Kedarius/ISPBreakout/images/pcb.jpg

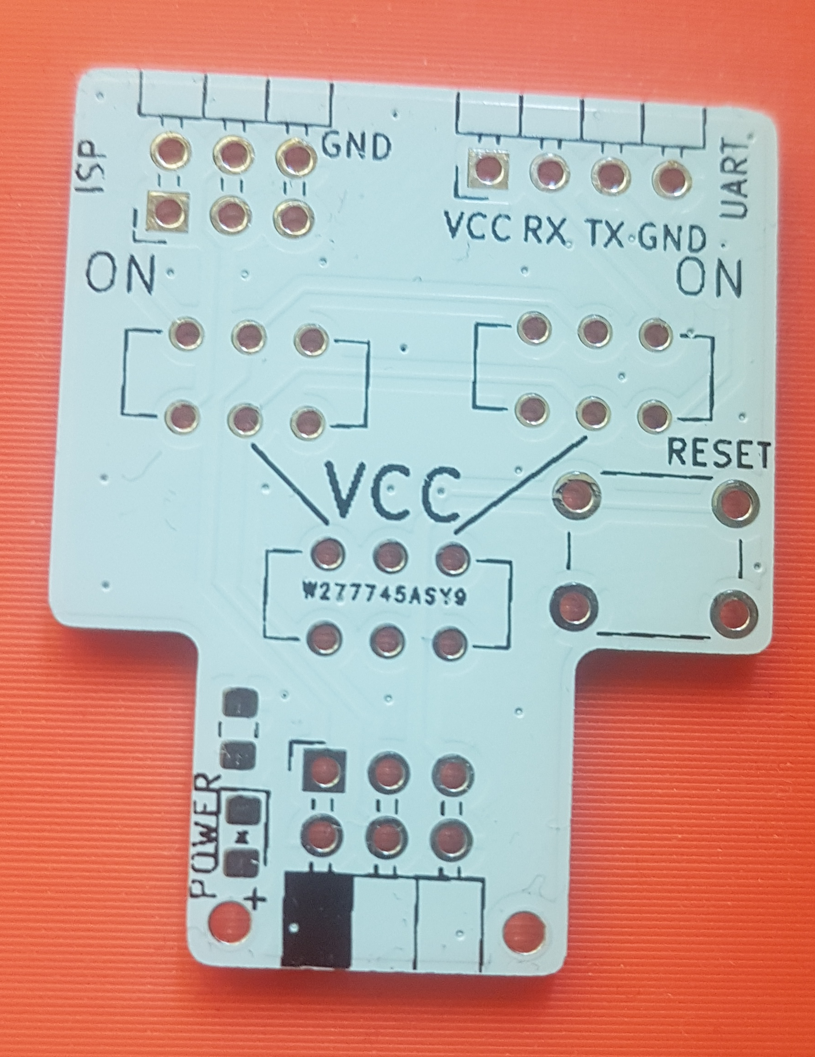
images/pcb.jpg
