Kedarius/ISPBreakout/K3-2235D/3d/K3-2235D-F1.stp

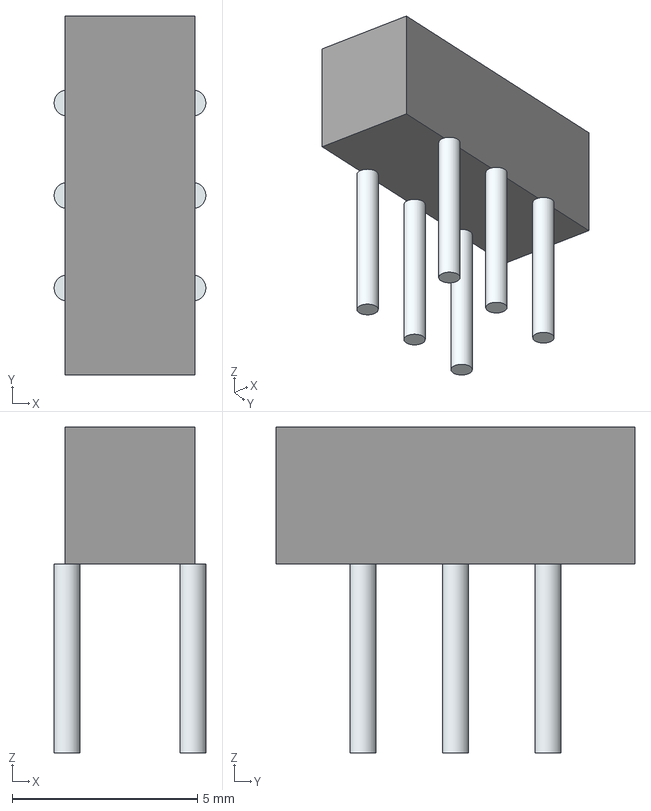
[picture p5: CAD file, 2021-03-07]
K3-2235D/3d/K3-2235D-F1.stp
4.10 x 9.70 x 8.80 mm
Leads x 6
