Kedarius/ISPBreakout/ispbreakout.kicad_pcb

## KiCad design ispbreakout.kicad_pcb (2021-03-07)

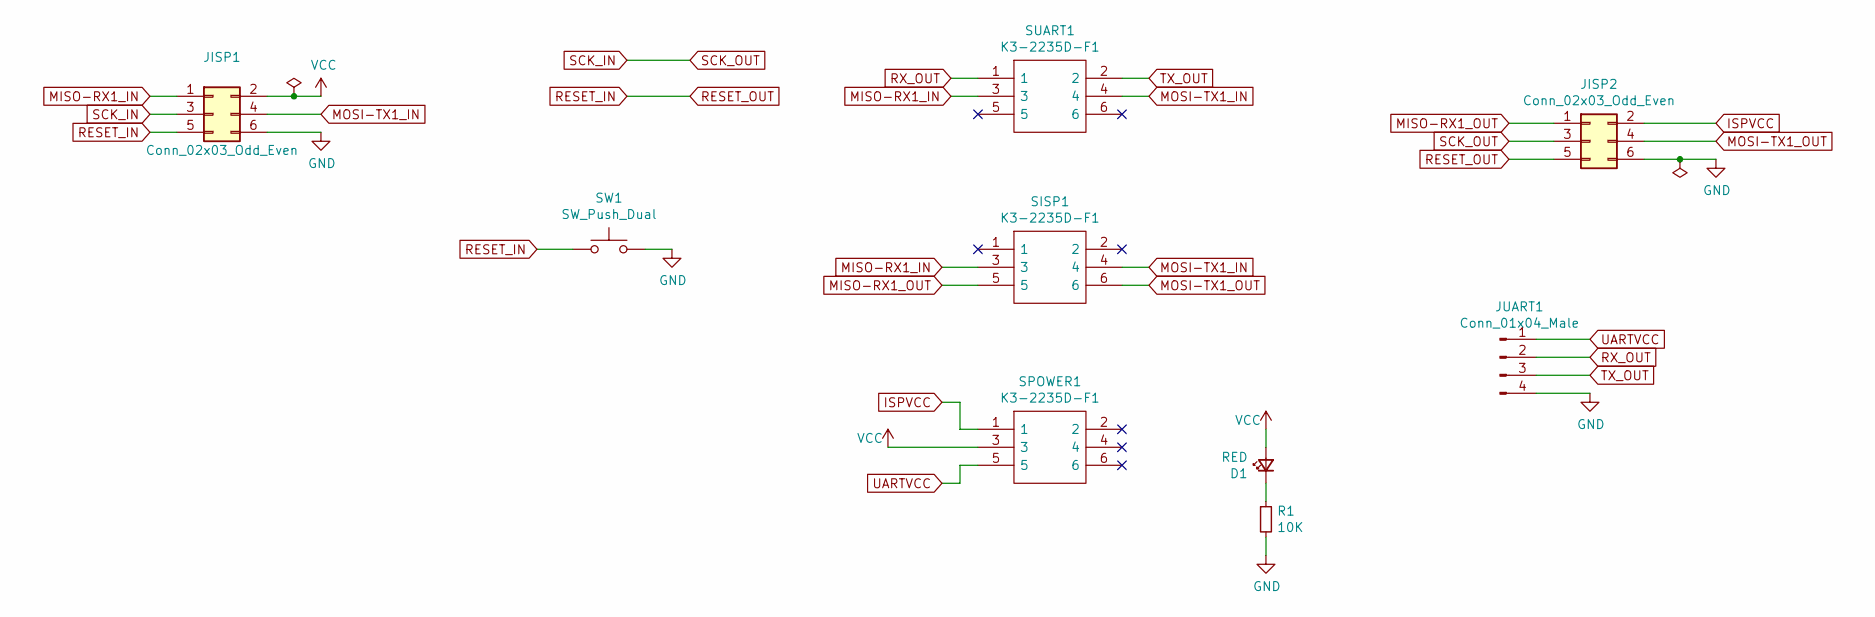
[picture p6: schematic ispbreakout.sch, ISPxUART breakout]

Parts:
D1: RED; LED_0805_2012Metric_Pad1.15x1.40mm_HandSolder
JISP1: Conn_02x03_Odd_Even; PinSocket_2x03_P2.54mm_Horizontal
JISP2: Conn_02x03_Odd_Even; PinHeader_2x03_P2.54mm_Horizontal
JUART1: Conn_01x04_Male; PinHeader_1x04_P2.54mm_Horizontal
R1: 10K; R_0805_2012Metric_Pad1.15x1.40mm_HandSolder
SISP1: K3-2235D-F1; K32235DF1; Manufacturer_Part_Number K3-2235D-F1
SPOWER1: K3-2235D-F1; K32235DF1; Manufacturer_Part_Number K3-2235D-F1
SUART1: K3-2235D-F1; K32235DF1; Manufacturer_Part_Number K3-2235D-F1
SW1: SW_Push_Dual; SW_PUSH_6mm

Connections:
GND: JISP1.6, JISP2.6, JUART1.4, R1.2, SW1.2
ISPVCC: JISP2.2, SPOWER1.1
MISO-RX1_IN: JISP1.1, SISP1.3, SUART1.3
MISO-RX1_OUT: JISP2.1, SISP1.5
MOSI-TX1_IN: JISP1.4, SISP1.4, SUART1.4
MOSI-TX1_OUT: JISP2.4, SISP1.6
unnamed: D1.1 (K), R1.1
RESET_IN: JISP1.5, JISP2.5, SW1.1
RX_OUT: JUART1.2, SUART1.1
SCK_IN: JISP1.3, JISP2.3
TX_OUT: JUART1.3, SUART1.2
UARTVCC: JUART1.1, SPOWER1.5
VCC: D1.2 (A), JISP1.2, SPOWER1.3

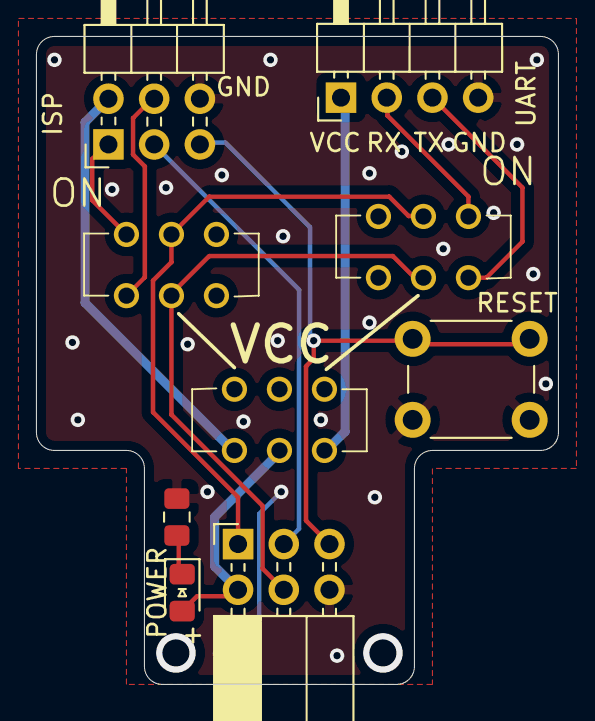
[picture p7: board ispbreakout.kicad_pcb from above]

Board: 2 copper layers, 29.0 x 36.0 mm, 9 parts (0 on the bottom side), 13 nets.
